0xCB-dev/RM-RASCAL-PCB/README.md

# RM-RASCAL-PCB

### Cute Macropad

TBD:

| Licence | OSHWA |
| :---: | :---: |
|  | (https://certification.oshwa.org/TBD.html) |

### Available here:

TBD

#### Flashing

- `qmk clone`
- `cd qmk_firmware`
- To go to bootloader press the reset button longer than 500ms and release.
- `make TBD`

### Assembly:

The PCBs are assembled at the fab with the production files located in the rev?/kikit/prod/ dir.

### PCB:

KiCad 6 stable

[Schematic](https://github.com/0xCB-dev/RM-RASCAL-PCB/blob/main/rev1.0/rascal.pdf)

#### View
Top | Bottom
:-------------------------:|:-------------------------:
  |  
#### BOM:

| Comment | Designator | Footprint | LCSC |
| --- | --- | --- | --- |
