0xCB-dev/RM-RASCAL-PCB/(commit log)

2023-03-05 repo init
    [pcb.kicad_pcb, pcb.kicad_sch]
2023-03-10 rev0.9 added
    Aktuellen Projektstand zum Anschauen rein commitet.
    Der Nose Switch SW7 ist noch auf der falschen Seite und braucht auch vermutlich noch einen anderen Footprint, weil ggf anderes Bauteil.
    Die Mounting Holes kommen vermutlich raus und werden vermutlich durch Notches im Edge Cut ersetzt. (Wird für Mounting ohne Plate gebraucht, beispielweise bei 6 Encodern.)
    [rascal-6.kicad_pcb, rascal-6.sch]
2023-03-12 initial cleanup. changed sk footprint, removed silk and traces
    [rascal-6.kicad_pcb, rascal-6.kicad_sch]
2023-03-12 fix lib link
    [rascal-6.kicad_pcb, rascal-6.kicad_sch]
2023-03-12 updated LED Matrix, broke ProMicro footprint
    [rascal-6.kicad_pcb, rascal-6.kicad_sch]
2023-03-13 fixed ProMicro footprint
    [rascal-6.kicad_pcb]
2023-03-14 first rough routing
    [rascal-6.kicad_pcb]
2023-03-18 changed VCC to plane, cleaned up some traces
    [rascal-6.kicad_pcb]
2023-05-14 add reset button
    [rascal-6.kicad_pcb, rascal-6.kicad_sch]
2023-05-18 get rotated
    [rascal-6.kicad_pcb]
2023-08-19 Mounting Screw Holes verschoben
    Die vier Mounting Holes haben sich mit dem Courtyard der Switches überlappt. Entsprechend nach oben bzw unten verschoben und den Edge Cut angepasst. DRC müsste nochmal überprüft werden.
    [rascal-6.kicad_pcb]
2023-08-25 minor fixes
    [rascal-6.kicad_pcb]
2023-08-26 fix drc
    [rascal-6.kicad_pcb]
